LucaGenini/Pillo_/pillo/pictures/Gadget.png

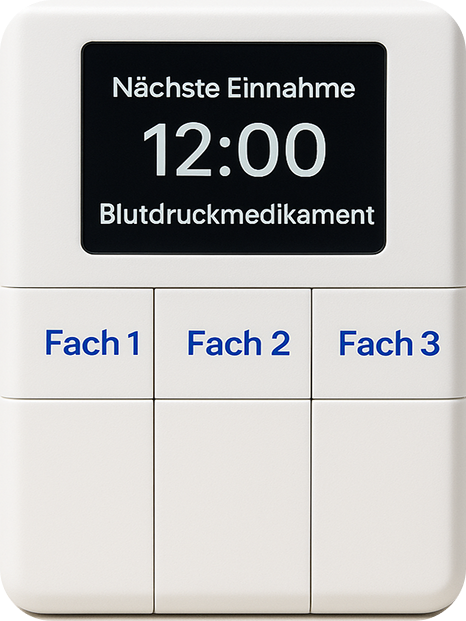
pillo/pictures/Gadget.png
